TankredMueller/BrewControl_AIO/AOI_Hutschiene_Schaltplan.pdf

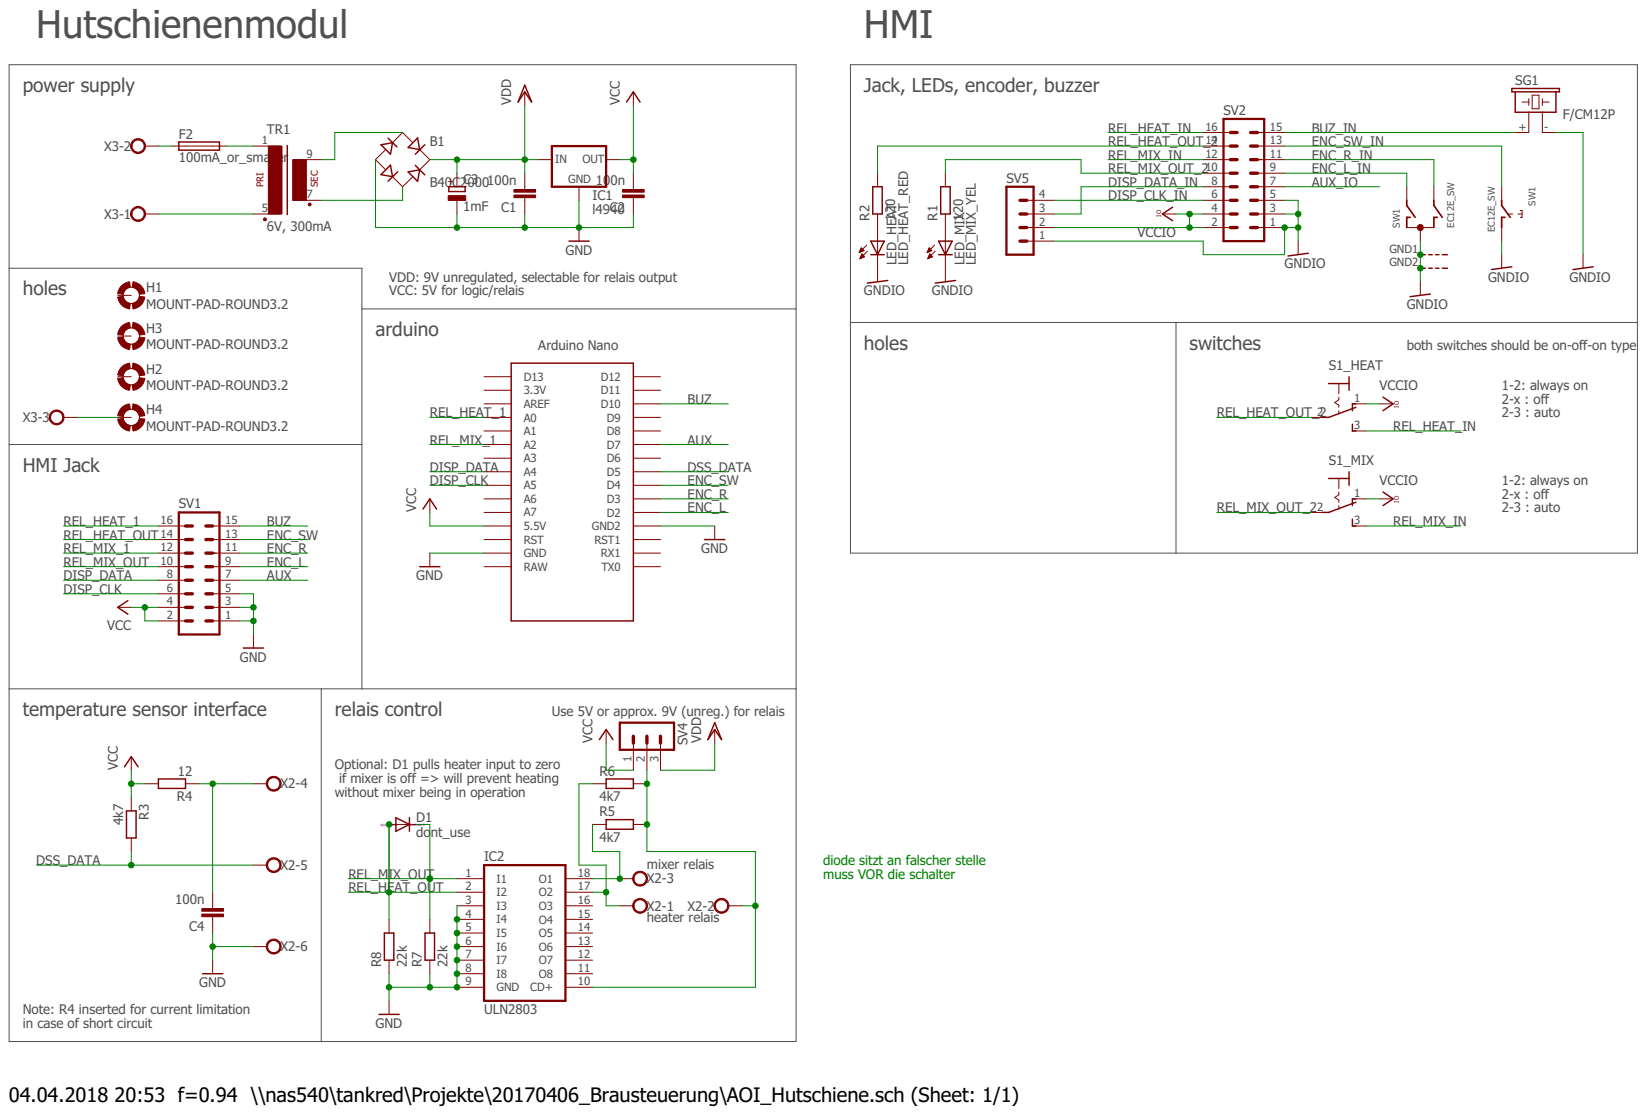
[picture p1: page 1]

Jack, LEDs, encoder, buzzer

VDD: 9V unregulated, selectable for relais output
VCC: 5V for logic/relais

both switches should be on-off-on type

Use 5V or approx. 9V (unreg.) for relais

Optional: D1 pulls heater input to zero
if mixer is off => will prevent heating without mixer being in operation

heater relais mixer relais

diode sitzt an falscher stelle muss VOR die schalter

4 | 16 O4
5 | 15 O5 14 O6

Note: R4 inserted for current limitation
in case of short circuit

04.04.2018 20:53 f=0.94 \\nas540\tankred\Projekte\20170406_Brausteuerung\AOI_Hutschiene.sch (Sheet: 1/1)
