TankredMueller/BrewControl_AIO/AOI_Hutschiene_Bestueckungsplan_Values.pdf

# v cut

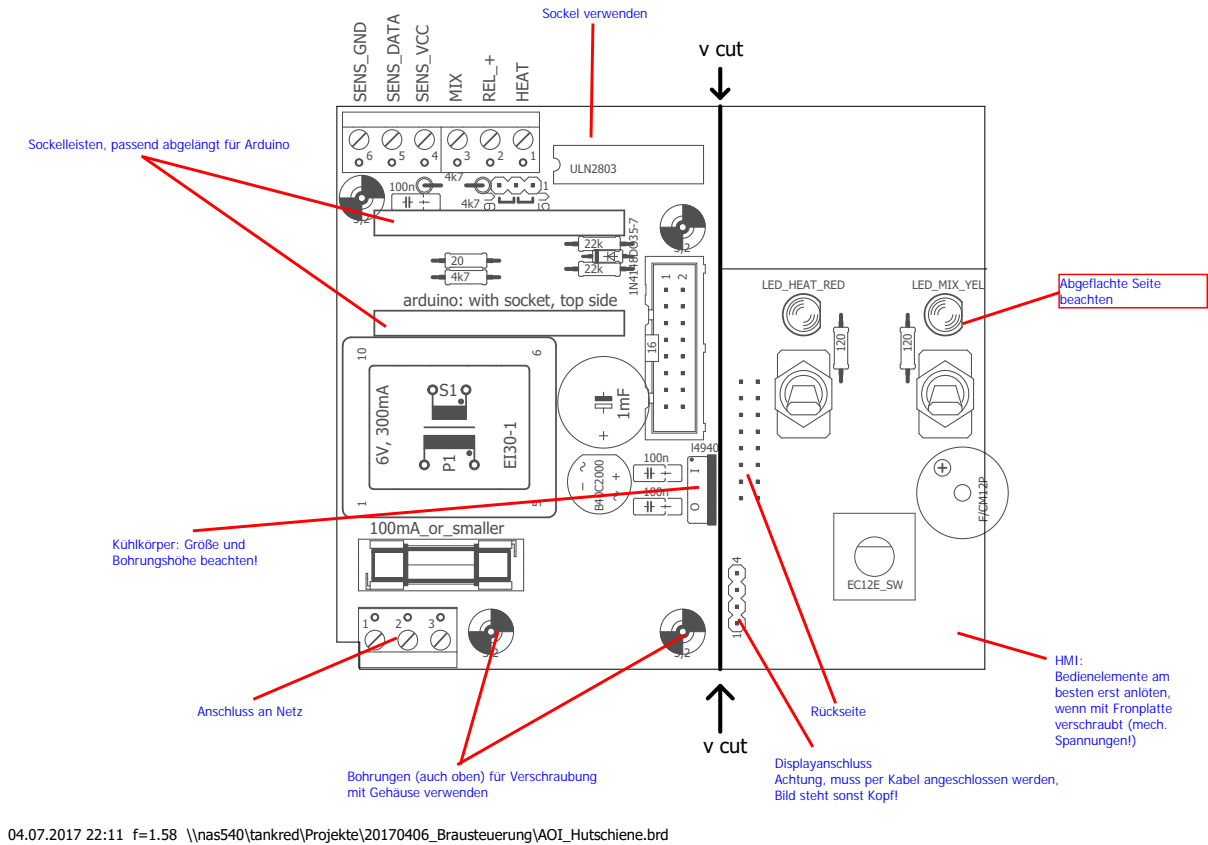
[picture p2: page 1]
ULN2803; LED_HEAT_RED; LED_MIX_YEL; 100mA_or_smaller; v cut; SENS_GND; SENS_DATA; SENS_VCC; MIX; REL_+; HEAT

arduino: with socket, top side

04.07.2017 22:11 f=1.58 \\nas540\tankred\Projekte\20170406_Brausteuerung\AOI_Hutschiene.brd¹⁶
