TankredMueller/BrewControl_AIO/AOI_Hutschiene.brd

## EAGLE design AOI_Hutschiene.brd (2018-04-04)

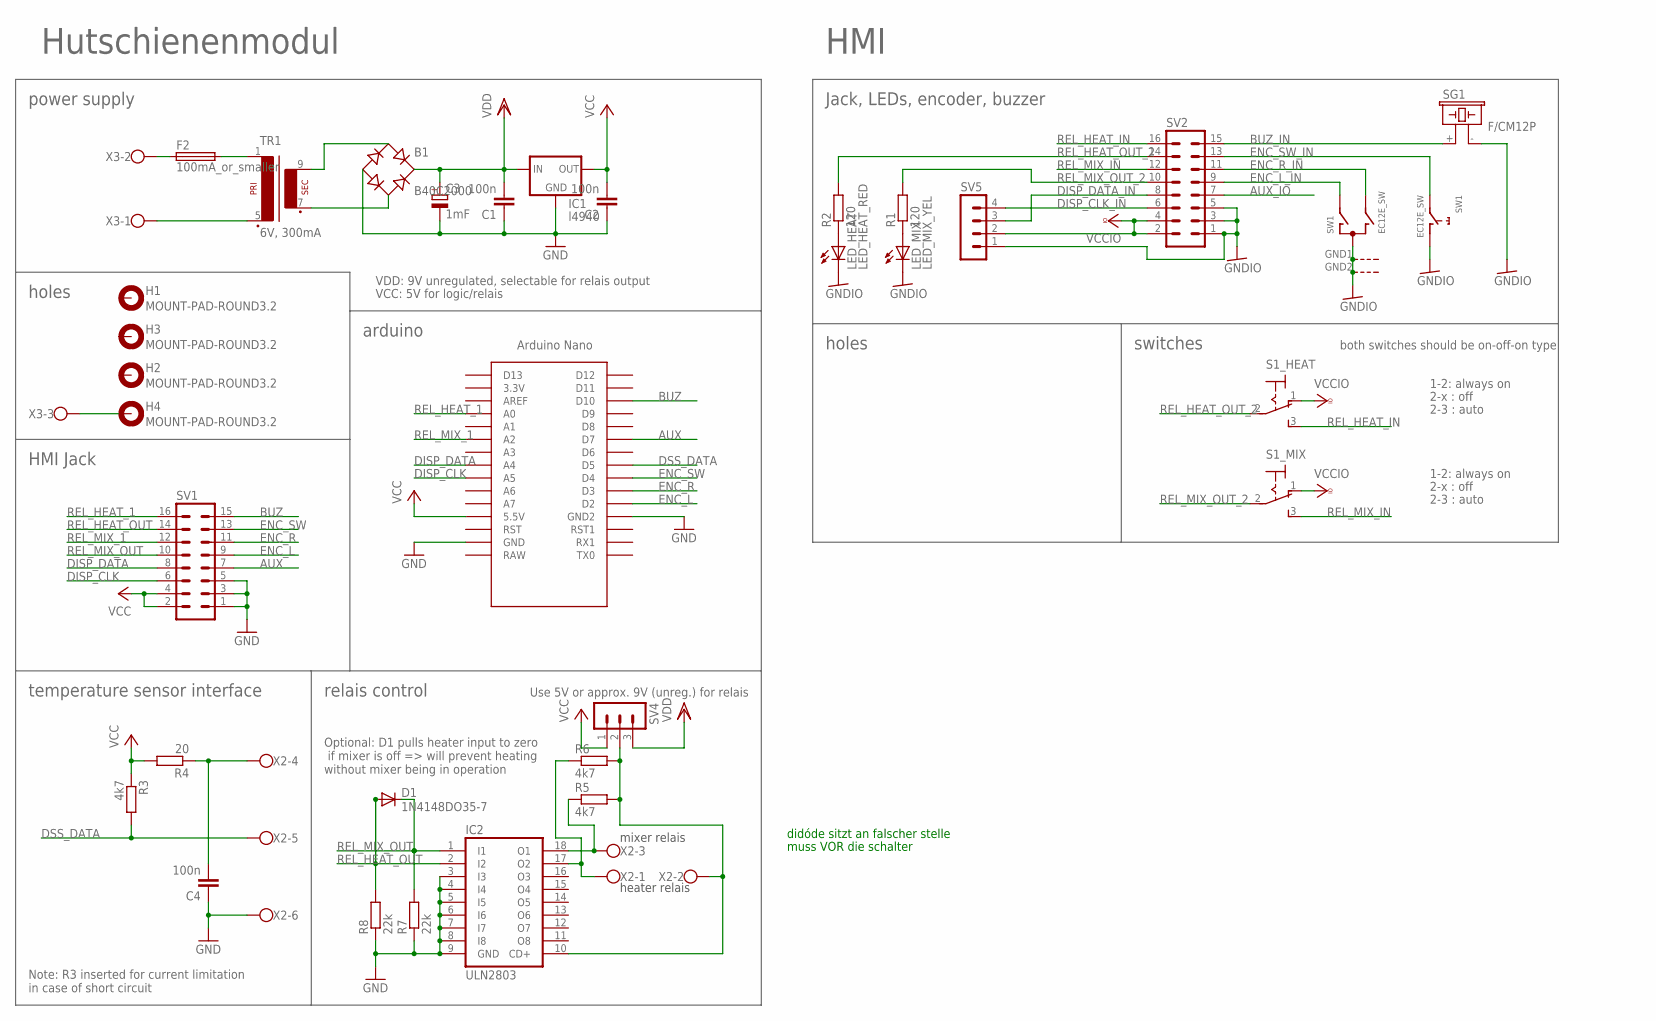
[picture p3: schematic AOI_Hutschiene.sch]

Parts:
B1: B40C2000; RB1A
C1, C2, C4: 100n; C025_050-025X075
C3: 1mF; E5-13
D1: 1N4148DO35-7; DO35-7
F2: 100mA_or_smaller; SH22,5
H1, H2, H3, H4: MOUNT-PAD-ROUND3.2; 3,2-PAD
IC1: l4940; 78XXS
IC2: ULN2803; DIL18
LED_HEAT: LED_HEAT_RED; LED5MM
LED_MIX: LED_MIX_YEL; LED5MM
R1, R2: 120; 0207/10
R3: 4k7; 0207/10
R4: 20; 0207/10
R5, R6: 4k7; 0207/2V
R7, R8: 22k; 0207/10
S1_HEAT, S1_MIX: M9040P
SG1: F/CM12P
SV1, SV2: ML16
SV4: MA03-1
SV5: MA04-1
SW1: EC12E_SW; ALPS_EC12E_SW
TR1: 6V, 300mA; EI30-1
U$1: ArdNano_with_socket; NANO
X2: W237-6
X3: W237-103

Connections:
AUX: SV1.7, U$1.D7
AUX_IO: SV2.7
BUZ: SV1.15, U$1.D10
BUZ_IN: SG1.+ (1), SV2.15
DISP_CLK: SV1.6, U$1.A5
DISP_CLK_IN: SV2.6, SV5.4
DISP_DATA: SV1.8, U$1.A4
DISP_DATA_IN: SV2.8, SV5.3
DSS_DATA: R3.2, U$1.D5, X2.5
ENC_L: SV1.9, U$1.D2
ENC_L_IN: SV2.9, SW1.A
ENC_R: SV1.11, U$1.D3
ENC_R_IN: SV2.11, SW1.B
ENC_SW: SV1.13, U$1.D4
ENC_SW_IN: SV2.13, SW1.E (2)
GND: B1.-, C1.1, C2.1, C3.-, C4.1, IC1.GND, IC2.3 (I3), IC2.4 (I4), IC2.5 (I5), IC2.6 (I6), IC2.7 (I7), IC2.8 (I8), IC2.9 (GND), R7.1, R8.1, SV1.1, SV1.3, SV1.5, U$1.GND, U$1.GND1 (GND2), X2.6
GNDIO: LED_HEAT.K (C), LED_MIX.K (C), SG1.- (2), SV2.1, SV2.3, SV2.5, SV5.1, SW1.C, SW1.D (1), SW1.GND1 (G), SW1.GND2 (G)
unnamed: IC2.10 (CD+), R5.2, R6.2, SV4.2, X2.2
unnamed: IC2.18 (O1), R5.1, X2.3
unnamed: IC2.17 (O2), R6.1, X2.1
unnamed: LED_HEAT.A, R2.1
unnamed: LED_MIX.A, R1.1
unnamed: F2.2, TR1.1
unnamed: F2.1, X3.2
unnamed: TR1.5 (P2), X3.1
unnamed: B1.AC1, TR1.9 (S4)
unnamed: B1.AC2, TR1.7 (S3)
unnamed: C4.2, R4.1, X2.4
unnamed: H4.B3,2, X3.3
REL_HEAT_1: SV1.16, U$1.A0
REL_HEAT_IN: S1_HEAT.3 (S), SV2.16
REL_HEAT_OUT: D1.A, IC2.2 (I2), R8.2, SV1.14
REL_HEAT_OUT_2: R2.2, S1_HEAT.2, SV2.14
REL_MIX_1: SV1.12, U$1.A2
REL_MIX_IN: S1_MIX.3 (S), SV2.12
REL_MIX_OUT: D1.C, IC2.1 (I1), R7.2, SV1.10
REL_MIX_OUT_2: R1.2, S1_MIX.2, SV2.10
VCC: C2.2, IC1.OUT, R3.1, R4.2, SV1.2, SV1.4, SV4.1, U$1.5V (5.5V)
VCCIO: S1_HEAT.1 (O), S1_MIX.1 (O), SV2.2, SV2.4, SV5.2
VDD: B1.+, C1.2, C3.+, IC1.IN, SV4.3

Notes on the sheet:
heater relais
mixer relais
Use 5V or approx. 9V (unreg.) for relais
power supply
arduino
Hutschienenmodul
HMI
holes
HMI Jack
Jack, LEDs, encoder, buzzer
switches
relais control
temperature sensor interface
VDD: 9V unregulated, selectable for relais output
VCC: 5V for logic/relais
Note: R3 inserted for current limitation in case of short circuit
1-2: always on
2-x : off
2-3 : auto
both switches should be on-off-on type
Optional: D1 pulls heater input to zero if mixer is off => will prevent heating without mixer being in operation
didóde sitzt an falscher stelle
muss VOR die schalter

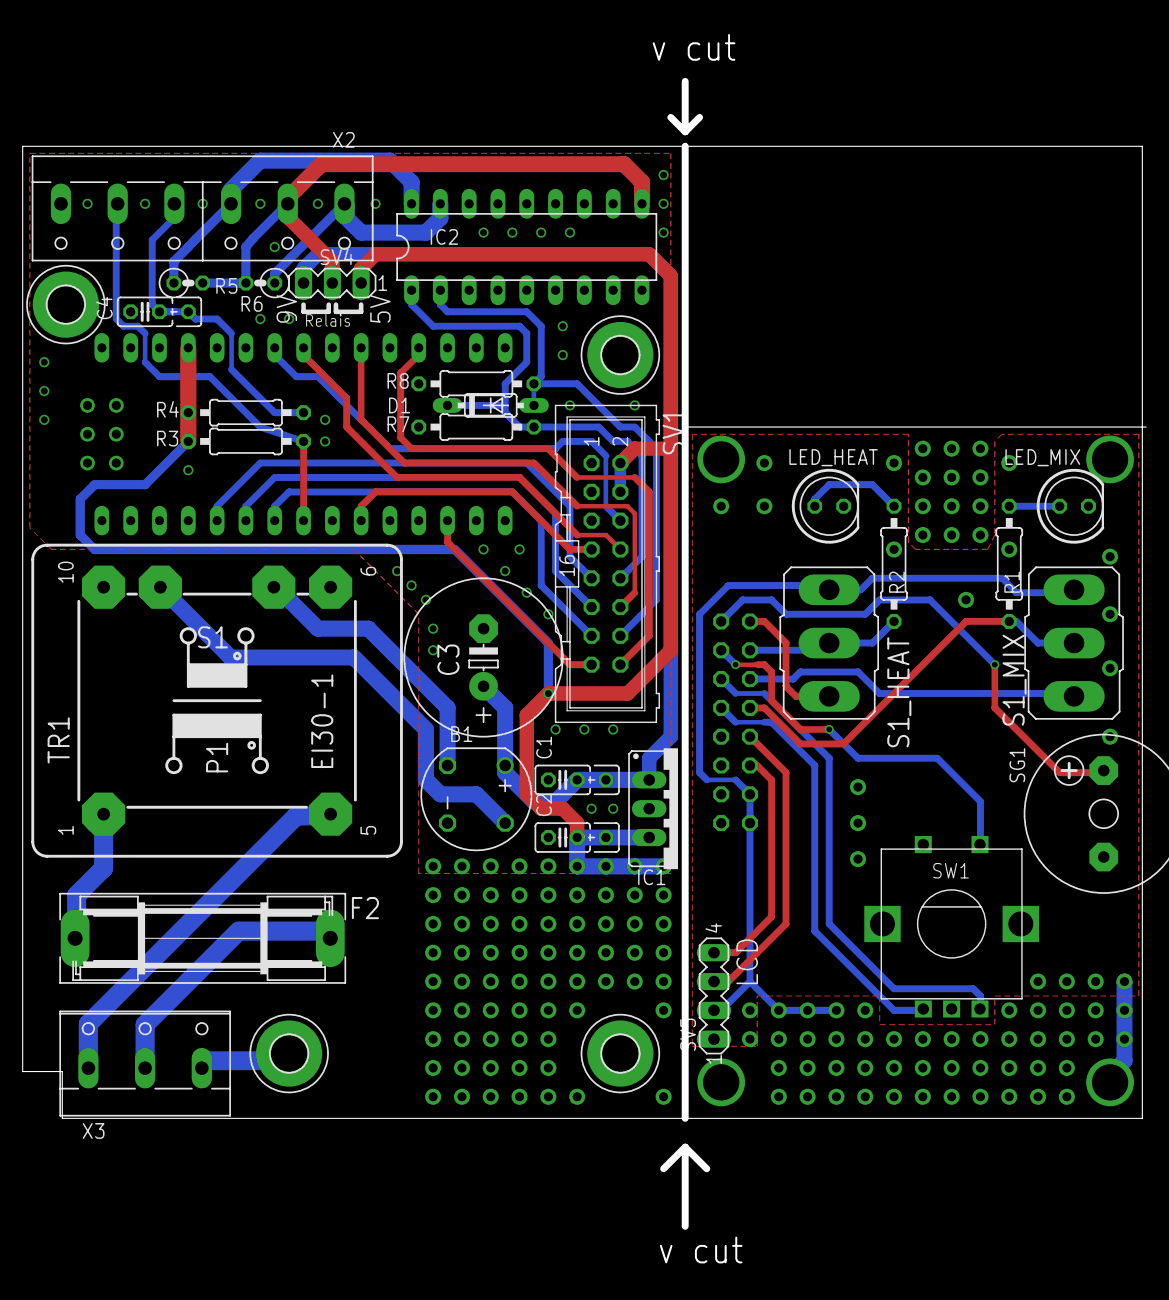
[picture p4: board AOI_Hutschiene.brd from above]

Board: 2 copper layers, 98.7 x 85.7 mm, 35 parts (1 on the bottom side), 39 nets.
