TankredMueller/BrewControl_AIO/AIO_project_wiring_plan.pdf

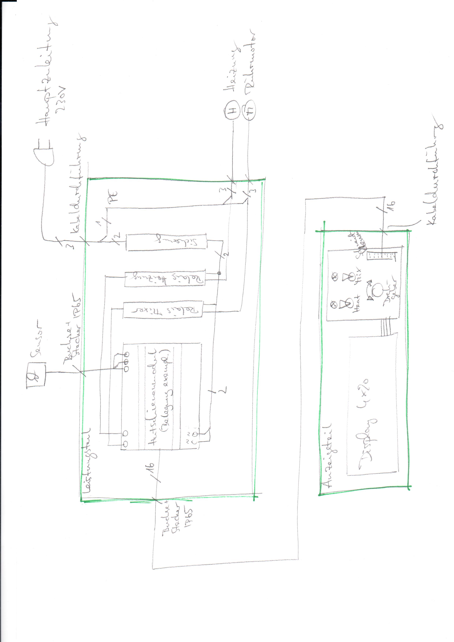
[picture p5: page 1]
