TankredMueller/BrewControl_AIO/(commit log)

2017-04-17 Initial upload of board file and schematic
    Initial upload of board file and schematic
    [AOI_Hutschiene.brd, AOI_Hutschiene.sch]
2017-04-17 added wiring plan
2017-07-04 updated design
    [AOI_Hutschiene.brd, AOI_Hutschiene.sch]
2017-07-04 added schematic and component mounting scheme
2018-04-04 Bugfixes to schematic and board (D1, R3/R4)
    - D1: Wrong position. Declared as "dont use"
    - R3/R4: Wrong silk screen position in PCB. Fixed by interchanging component names in schematic
    [AOI_Hutschiene.brd, AOI_Hutschiene.sch]
